nekuneko/ExSoKskeletal-Mitt/README.md

# ExSoKskeletal Mitt
Robotic Hand for ICTUS patients based on SoK (System on Keyring) boards.

Usign Autodesk EAGLE 9.5.2
