nekuneko/ExSoKskeletal-Mitt/Doc/sensor schematic.jpg

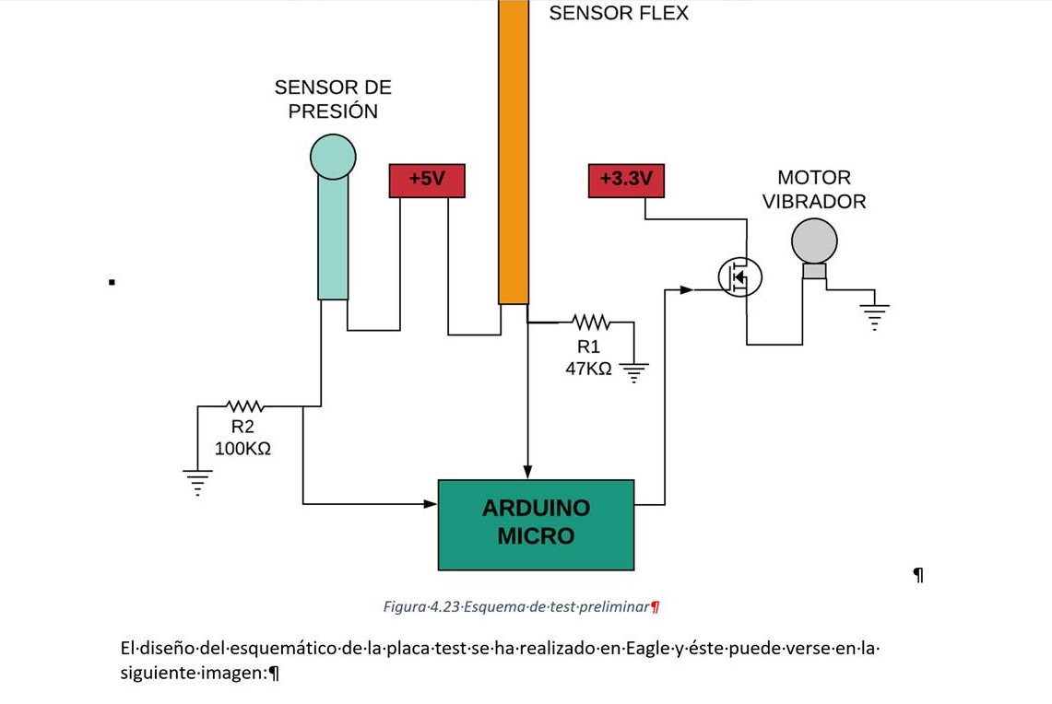
Doc/sensor schematic.jpg
