nekuneko/ExSoKskeletal-Mitt/PCB/finger/finger_changelog.txt

Finger 1.3 adds
	+ Resistor R5 is doubled to GND and 3.3V to allow potentiometer select I2C address easily.
