nekuneko/ExSoKskeletal-Mitt/PCB/hand/hand_rev_1.1_a.brd

## EAGLE design PCB/hand/hand_rev_1.1_a.brd (2019-07-13)

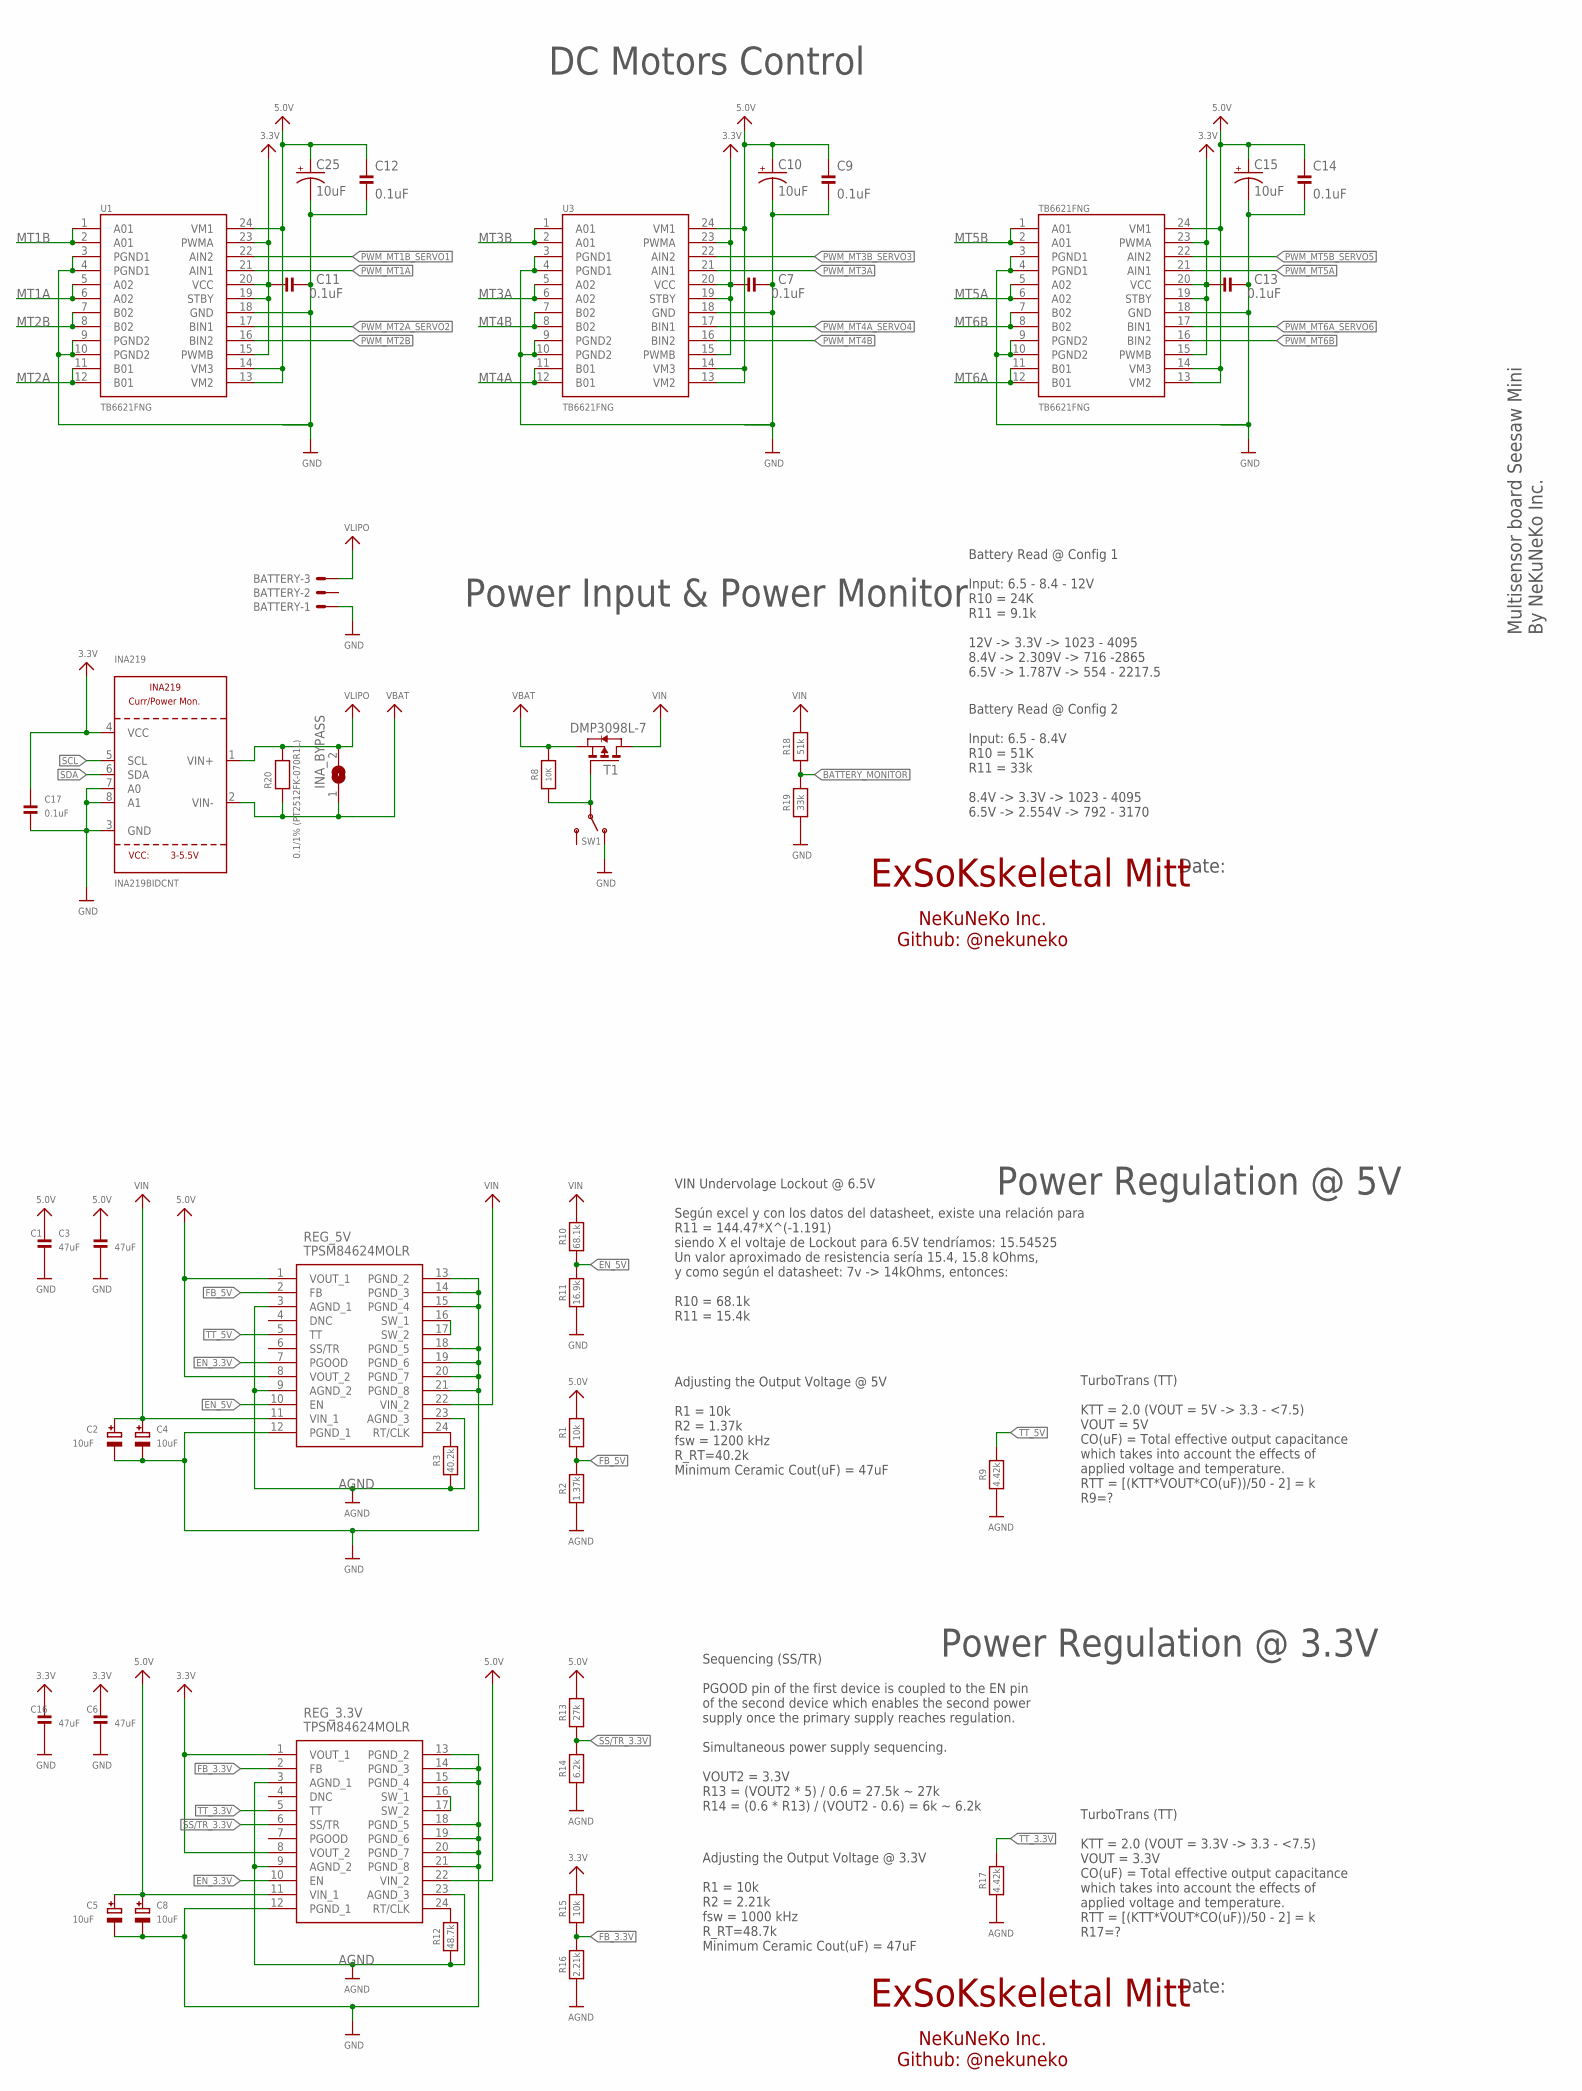
[picture p2: schematic hand_rev_1.1_a.sch, part in row 1, column 1]

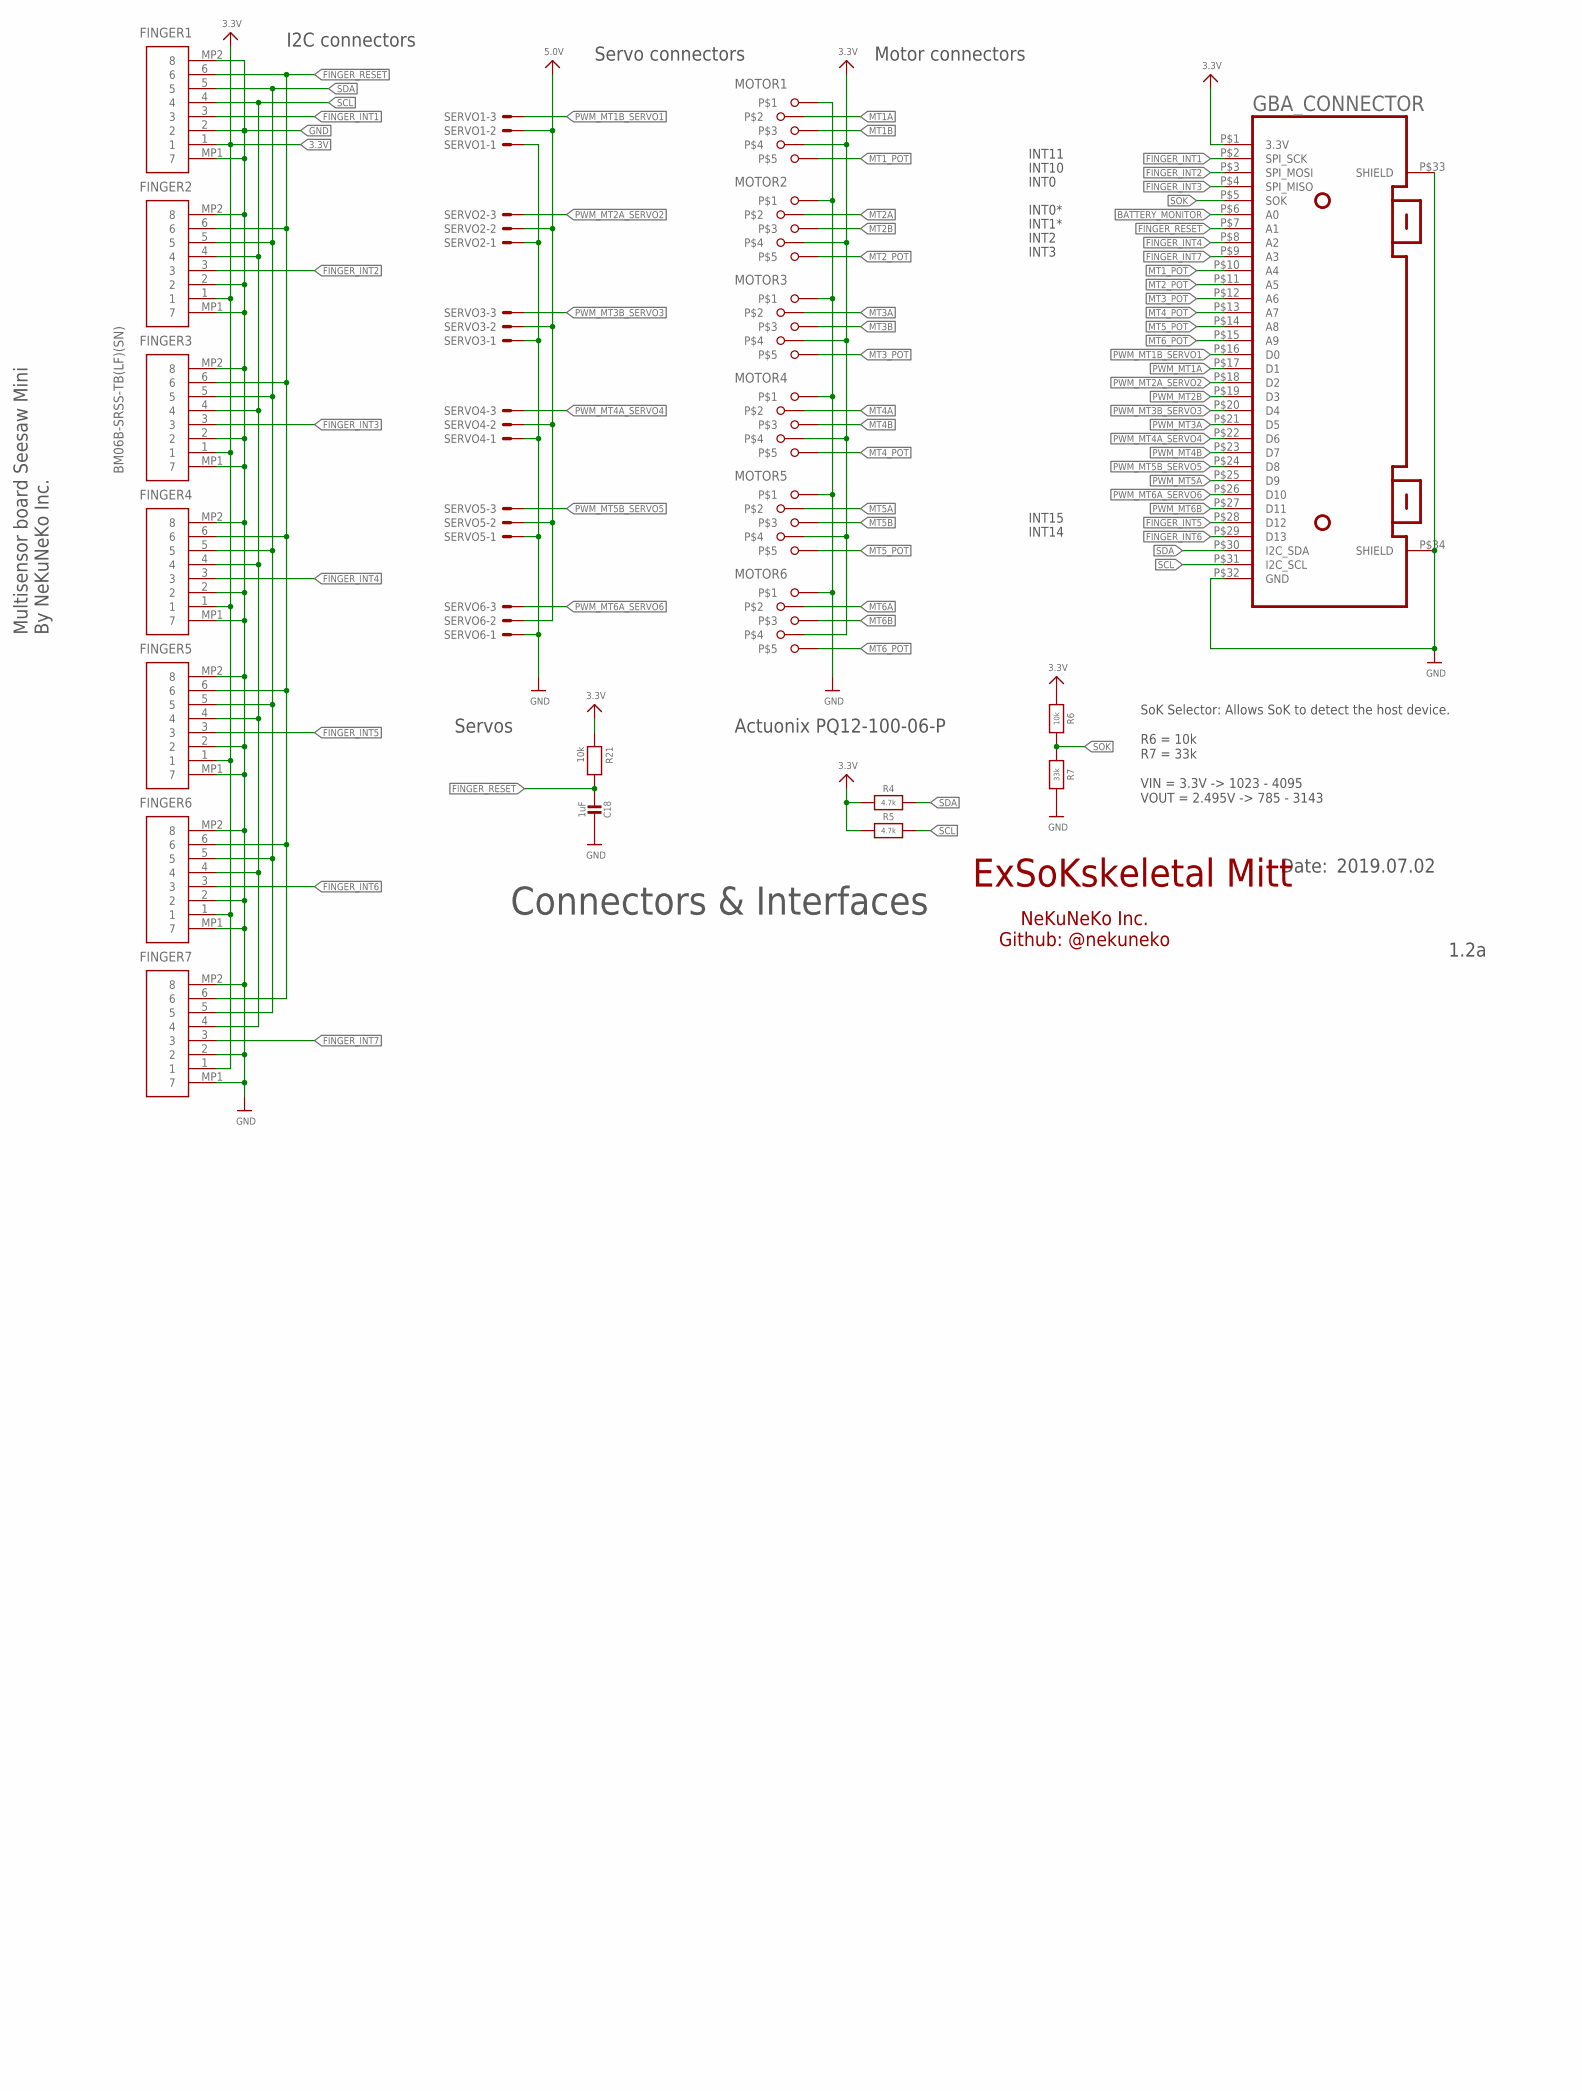
[picture p3: schematic hand_rev_1.1_a.sch, part in row 1, column 2]

Parts:
BATTERY: JST-XH-03-PIN-LONG-PAD; JST-XH-03-PACKAGE-LONG-PAD
C1, C3, C6, C16: 47uF; _0603
C2, C4, C5, C8: 10uF; EIA3216-18/A-R
C7, C9, C11, C12, C13, C14, C17: 0.1uF; _0603
C10, C15, C25: 10uF; 0603-POLAR; MPN F981A106MMA
C18: 1uF; MICROBUILDER__0603
FINGER1, FINGER2, FINGER3, FINGER4, FINGER5, FINGER6, FINGER7: BM06B-SRSS-TB(LF)(SN); BM06BSRSSTBLFSN
GBA_CONNECTOR: GBA_CARTRIDGEGBA_CARTRIDGE2; GBA_CARTRIDGE2
INA219: INA219BIDCNT; SOT23-8
INA_BYPASS: SOLDERJUMPERREFLOW_NOPASTE; SOLDERJUMPER_REFLOW_NOPASTE
MOTOR1, MOTOR2, MOTOR3, MOTOR4, MOTOR5, MOTOR6: Actuonix PQ12-100-06-P; 5PIN
R1, R6, R15, R21: 10k; _0603
R2: 1.37k; _0603
R3: 40.2k; _0603
R4, R5: 4.7k; _0603
R7, R19: 33k; _0603
R8: 10K; _0805
R9, R17: 4.42k; _0603
R10: 68.1k; _0603
R11: 16.9k; _0603
R12: 48.7k; _0603
R13: 27k; _0603
R14: 6.2k; _0603
R16: 2.21k; _0603
R18: 51k; _0603
R20: 0.1/1% (PT2512FK-070R1L); 2512
REG_3.3V, REG_5V: TPSM84624MOLR
SERVO1, SERVO2, SERVO3, SERVO4, SERVO5, SERVO6: JST-XH-03-PIN-LONG-PAD; JST-XH-03-PACKAGE-LONG-PAD
SW1: SWITCH_SPDT; SPDT_SMT_SSSS811101
T1: DMP3098L-7; SOT-23
TB6621FNG: TB6621FNG; SSOP24
U1, U3: TB6621FNG; SSOP24

Connections:
3.3V: C6.2, C7.1, C11.1, C13.1, C16.2, C17.2, FINGER1.1, FINGER2.1, FINGER3.1, FINGER4.1, FINGER5.1, FINGER6.1, FINGER7.1, GBA_CONNECTOR.P$1 (3.3V), INA219.4 (VCC), MOTOR1.4, MOTOR2.4, MOTOR3.4, MOTOR4.4, MOTOR5.4, MOTOR6.4, R4.1, R5.1, R6.1, R15.2, R21.1, REG_3.3V.1 (VOUT_1), REG_3.3V.8 (VOUT_2), TB6621FNG.15 (PWMB), TB6621FNG.19 (STBY), TB6621FNG.20 (VCC), TB6621FNG.23 (PWMA), U1.15 (PWMB), U1.19 (STBY), U1.20 (VCC), U1.23 (PWMA), U3.15 (PWMB), U3.19 (STBY), U3.20 (VCC), U3.23 (PWMA)
5.0V: C1.2, C3.2, C5.+, C8.+, C9.2, C10.+, C12.2, C14.2, C15.+, C25.+, R1.2, R13.2, REG_3.3V.11 (VIN_1), REG_3.3V.22 (VIN_2), REG_5V.1 (VOUT_1), REG_5V.8 (VOUT_2), SERVO1.2, SERVO2.2, SERVO3.2, SERVO4.2, SERVO5.2, SERVO6.2, TB6621FNG.13 (VM2), TB6621FNG.14 (VM3), TB6621FNG.24 (VM1), U1.13 (VM2), U1.14 (VM3), U1.24 (VM1), U3.13 (VM2), U3.14 (VM3), U3.24 (VM1)
AGND: R2.1, R3.1, R9.1, R12.1, R14.1, R16.1, R17.1, REG_3.3V.3 (AGND_1), REG_3.3V.9 (AGND_2), REG_3.3V.23 (AGND_3), REG_5V.3 (AGND_1), REG_5V.9 (AGND_2), REG_5V.23 (AGND_3)
BATTERY_MONITOR: GBA_CONNECTOR.P$6 (A0), R18.1, R19.2
EN_3.3V: REG_3.3V.10 (EN), REG_5V.7 (PGOOD)
EN_5V: R10.1, R11.2, REG_5V.10 (EN)
FB_3.3V: R15.1, R16.2, REG_3.3V.2 (FB)
FB_5V: R1.1, R2.2, REG_5V.2 (FB)
FINGER_!RESET: C18.2, FINGER1.6, FINGER2.6, FINGER3.6, FINGER4.6, FINGER5.6, FINGER6.6, FINGER7.6, GBA_CONNECTOR.P$7 (A1), R21.2
FINGER_INT1: FINGER1.3, GBA_CONNECTOR.P$2 (SPI_SCK)
FINGER_INT2: FINGER2.3, GBA_CONNECTOR.P$3 (SPI_MOSI)
FINGER_INT3: FINGER3.3, GBA_CONNECTOR.P$4 (SPI_MISO)
FINGER_INT4: FINGER4.3, GBA_CONNECTOR.P$8 (A2)
FINGER_INT5: FINGER5.3, GBA_CONNECTOR.P$28 (D12)
FINGER_INT6: FINGER6.3, GBA_CONNECTOR.P$29 (D13)
FINGER_INT7: FINGER7.3, GBA_CONNECTOR.P$9 (A3)
GND: BATTERY.1, C1.1, C2.-, C3.1, C4.-, C5.-, C6.1, C7.2, C8.-, C9.1, C10.-, C11.2, C12.1, C13.2, C14.1, C15.-, C16.1, C17.1, C18.1, C25.-, FINGER1.2, FINGER1.MP1 (7), FINGER1.MP2 (8), FINGER2.2, FINGER2.MP1 (7), FINGER2.MP2 (8), FINGER3.2, FINGER3.MP1 (7), FINGER3.MP2 (8), FINGER4.2, FINGER4.MP1 (7), FINGER4.MP2 (8), FINGER5.2, FINGER5.MP1 (7), FINGER5.MP2 (8), FINGER6.2, FINGER6.MP1 (7), FINGER6.MP2 (8), FINGER7.2, FINGER7.MP1 (7), FINGER7.MP2 (8), GBA_CONNECTOR.P$32 (GND), GBA_CONNECTOR.P$33 (SHIELD), GBA_CONNECTOR.P$34 (SHIELD), INA219.3 (GND), INA219.7 (A0), INA219.8 (A1), MOTOR1.1, MOTOR2.1, MOTOR3.1, MOTOR4.1, MOTOR5.1, MOTOR6.1, R7.2, R11.1, R19.1, REG_3.3V.12 (PGND_1), REG_3.3V.13 (PGND_2), REG_3.3V.14 (PGND_3), REG_3.3V.15 (PGND_4), REG_3.3V.18 (PGND_5), REG_3.3V.19 (PGND_6), REG_3.3V.20 (PGND_7), REG_3.3V.21 (PGND_8), REG_5V.12 (PGND_1), REG_5V.13 (PGND_2), REG_5V.14 (PGND_3), REG_5V.15 (PGND_4), REG_5V.18 (PGND_5), REG_5V.19 (PGND_6), REG_5V.20 (PGND_7), REG_5V.21 (PGND_8), SERVO1.1, SERVO2.1, SERVO3.1, SERVO4.1, SERVO5.1, SERVO6.1, SW1.A (O), TB6621FNG.3 (PGND1), TB6621FNG.4 (PGND1), TB6621FNG.9 (PGND2), TB6621FNG.10 (PGND2), TB6621FNG.18 (GND), U1.3 (PGND1), U1.4 (PGND1), U1.9 (PGND2), U1.10 (PGND2), U1.18 (GND), U3.3 (PGND1), U3.4 (PGND1), U3.9 (PGND2), U3.10 (PGND2), U3.18 (GND)
MT1A: MOTOR1.2, U1.5 (A02), U1.6 (A02)
MT1B: MOTOR1.3, U1.1 (A01), U1.2 (A01)
MT1_POT: GBA_CONNECTOR.P$10 (A4), MOTOR1.5
MT2A: MOTOR2.2, U1.11 (B01), U1.12 (B01)
MT2B: MOTOR2.3, U1.7 (B02), U1.8 (B02)
MT2_POT: GBA_CONNECTOR.P$11 (A5), MOTOR2.5
MT3A: MOTOR3.2, U3.5 (A02), U3.6 (A02)
MT3B: MOTOR3.3, U3.1 (A01), U3.2 (A01)
MT3_POT: GBA_CONNECTOR.P$12 (A6), MOTOR3.5
MT4A: MOTOR4.2, U3.11 (B01), U3.12 (B01)
MT4B: MOTOR4.3, U3.7 (B02), U3.8 (B02)
MT4_POT: GBA_CONNECTOR.P$13 (A7), MOTOR4.5
MT5A: MOTOR5.2, TB6621FNG.5 (A02), TB6621FNG.6 (A02)
MT5B: MOTOR5.3, TB6621FNG.1 (A01), TB6621FNG.2 (A01)
MT5_POT: GBA_CONNECTOR.P$14 (A8), MOTOR5.5
MT6A: MOTOR6.2, TB6621FNG.11 (B01), TB6621FNG.12 (B01)
MT6B: MOTOR6.3, TB6621FNG.7 (B02), TB6621FNG.8 (B02)
MT6_POT: GBA_CONNECTOR.P$15 (A9), MOTOR6.5
unnamed: R8.1, SW1.B, T1.3 (G)
unnamed: REG_5V.16 (SW_1), REG_5V.17 (SW_2)
unnamed: R12.2, REG_3.3V.24 (RT/CLK)
unnamed: REG_3.3V.16 (SW_1), REG_3.3V.17 (SW_2)
unnamed: R3.2, REG_5V.24 (RT/CLK)
PWM_MT1A: GBA_CONNECTOR.P$17 (D1), U1.21 (AIN1)
PWM_MT1B_SERVO1: GBA_CONNECTOR.P$16 (D0), SERVO1.3, U1.22 (AIN2)
PWM_MT2A_SERVO2: GBA_CONNECTOR.P$18 (D2), SERVO2.3, U1.17 (BIN1)
PWM_MT2B: GBA_CONNECTOR.P$19 (D3), U1.16 (BIN2)
PWM_MT3A: GBA_CONNECTOR.P$21 (D5), U3.21 (AIN1)
PWM_MT3B_SERVO3: GBA_CONNECTOR.P$20 (D4), SERVO3.3, U3.22 (AIN2)
PWM_MT4A_SERVO4: GBA_CONNECTOR.P$22 (D6), SERVO4.3, U3.17 (BIN1)
PWM_MT4B: GBA_CONNECTOR.P$23 (D7), U3.16 (BIN2)
PWM_MT5A: GBA_CONNECTOR.P$25 (D9), TB6621FNG.21 (AIN1)
PWM_MT5B_SERVO5: GBA_CONNECTOR.P$24 (D8), SERVO5.3, TB6621FNG.22 (AIN2)
PWM_MT6A_SERVO6: GBA_CONNECTOR.P$26 (D10), SERVO6.3, TB6621FNG.17 (BIN1)
PWM_MT6B: GBA_CONNECTOR.P$27 (D11), TB6621FNG.16 (BIN2)
SCL: FINGER1.4, FINGER2.4, FINGER3.4, FINGER4.4, FINGER5.4, FINGER6.4, FINGER7.4, GBA_CONNECTOR.P$31 (I2C_SCL), INA219.5 (SCL), R5.2
SDA: FINGER1.5, FINGER2.5, FINGER3.5, FINGER4.5, FINGER5.5, FINGER6.5, FINGER7.5, GBA_CONNECTOR.P$30 (I2C_SDA), INA219.6 (SDA), R4.2
SOK: GBA_CONNECTOR.P$5 (SOK), R6.2, R7.1
SS/TR_3.3V: R13.1, R14.2, REG_3.3V.6 (SS/TR)
TT_3.3V: R17.2, REG_3.3V.5 (TT)
TT_5V: R9.2, REG_5V.5 (TT)
VBAT: INA219.2 (VIN-), INA_BYPASS.1, R8.2, R20.1, T1.2 (S)
VIN: C2.+, C4.+, R10.2, R18.2, REG_5V.11 (VIN_1), REG_5V.22 (VIN_2), T1.1 (D)
VLIPO: BATTERY.3, INA219.1 (VIN+), INA_BYPASS.2, R20.2

Notes on the sheet:
ExSoKskeletal Mitt
VIN Undervolage Lockout @ 6.5V Según excel y con los datos del datasheet, existe una relación para R11 = 144.47*X^(-1.191) siendo X el voltaje de Lockout para 6.5V tendríamos: 15.54525 Un valor aproximado de resistencia sería 15.4, 15.8 kOhms, y como según el datasheet: 7v -> 14kOhms, entonces: R10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
Adjusting the Output Voltage @ 5V R1 = 10k R2 = 1.37k fsw = 1200 kHz R_RT=40.2k Minimum Ceramic Cout(uF) = 47uF
Sequencing (SS/TR) PGOOD pin of the first device is coupled to the EN pin of the second device which enables the second power supply once the primary supply reaches regulation. Simultaneous power supply sequencing. VOUT2 = 3.3V R13 = (VOUT2 * 5) / 0.6 = 27.5k ~ 27k R14 = (0.6 * R13) / (VOUT2 - 0.6)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
Adjusting the Output Voltage @ 3.3V R1 = 10k R2 = 2.21k fsw = 1000 kHz R_RT=48.7k Minimum Ceramic Cout(uF) = 47uF
TurboTrans (TT) KTT = 2.0 (VOUT = 5V -> 3.3 - <7.5) VOUT = 5V CO(uF) = Total effective output capacitance which takes into account the effects of applied voltage and temperature. RTT = [(KTT*VOUT*CO(uF))/50 - 2] = k R9=?
TurboTrans (TT) KTT = 2.0 (VOUT = 3.3V -> 3.3 - <7.5) VOUT = 3.3V CO(uF) = Total effective output capacitance which takes into account the effects of applied voltage and temperature. RTT = [(KTT*VOUT*CO(uF))/50 - 2] = k R17=?
INT11
INT10
INT0
INT0*
INT1*
INT2
INT3
INT14
INT15
Battery Read @ Config 2 Input: 6.5 - 8.4V R10 = 51K R11 = 33k 8.4V -> 3.3V -> 1023 - 4095 6.5V -> 2.554V -> 792 - 3170
Power Input & Power Monitor
Power Regulation @ 5V
Power Regulation @ 3.3V
DC Motors Control
Connectors & Interfaces
NeKuNeKo Inc. Github: @nekuneko
Date:
SoK Selector: Allows SoK to detect the host device. R6 = 10k R7 = 33k VIN = 3.3V -> 1023 - 4095 VOUT = 2.495V -> 785 - 3143
I2C connectors
Servo connectors
Motor connectors
Actuonix PQ12-100-06-P
Multisensor board Seesaw Mini By NeKuNeKo Inc.
Servos
Battery Read @ Config 1 Input: 6.5 - 8.4 - 12V R10 = 24K R11 = 9.1k 12V -> 3.3V -> 1023 - 4095 8.4V -> 2.309V -> 716 -2865 6.5V -> 1.787V -> 554 - 2217.5

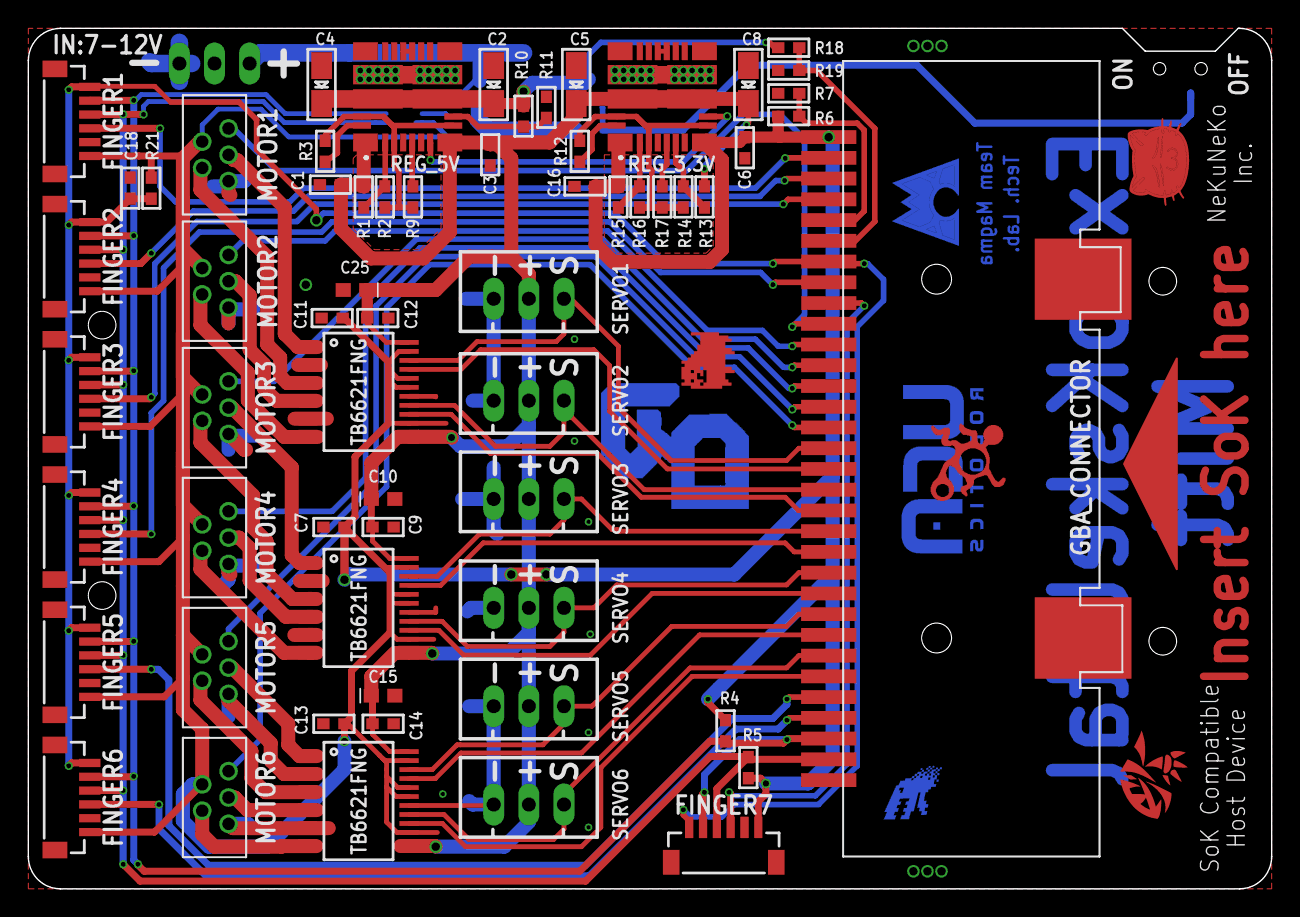
[picture p4: board hand_rev_1.1_a.brd from above]

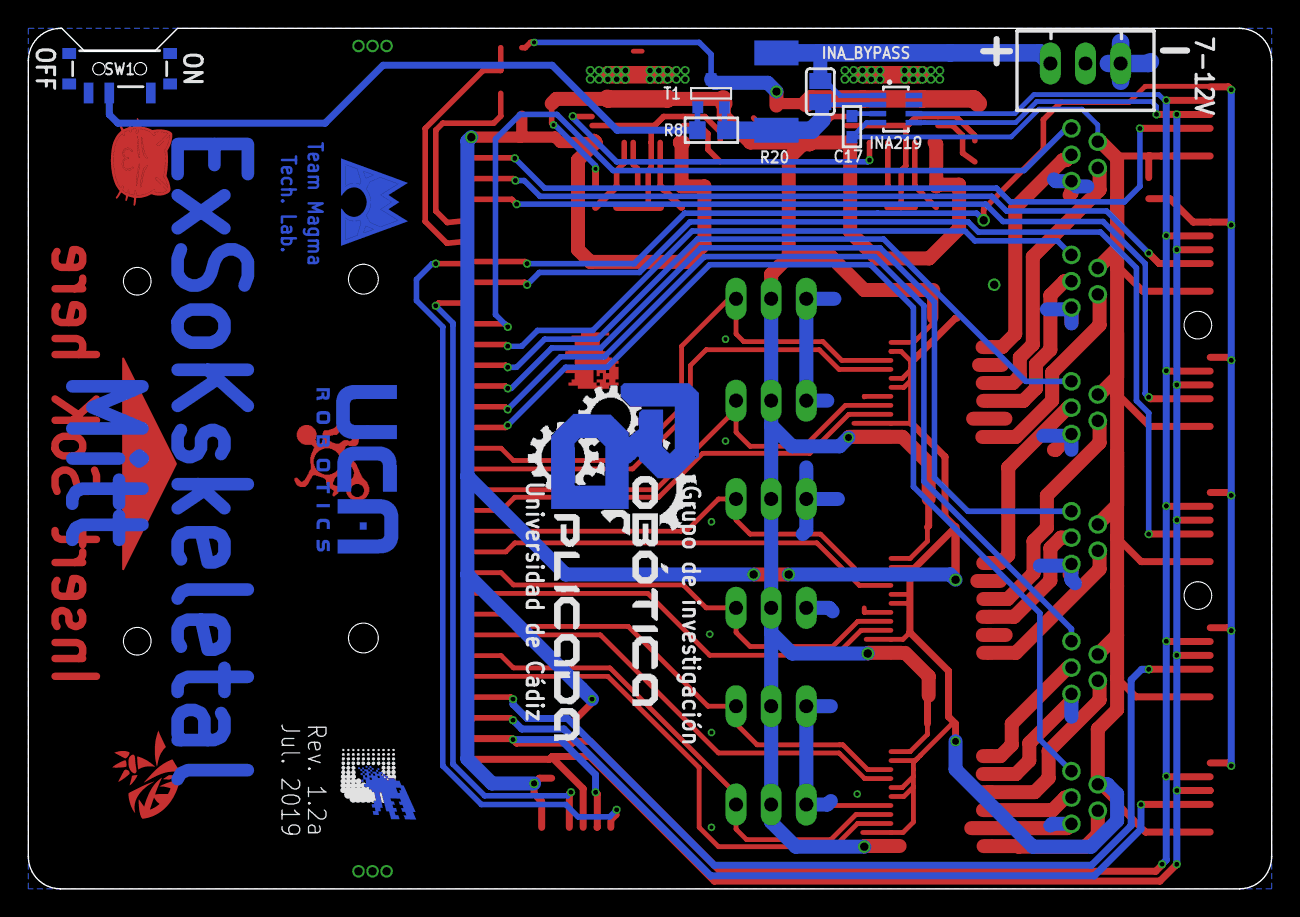
[picture p5: board hand_rev_1.1_a.brd from below]

Board: 2 copper layers, 89.9 x 62.2 mm, 79 parts (12 on the bottom side), 61 nets.

Other parts of the board:
U$6: NEKO_6_5_BORDE_TSTOP
U$7: SOK_FINISH
U$8: DOG_FINISH
U$9: MAGMA
U$14: UCAROBOTICS
U$48: GIRA_2_DRAWN_14
U$50: TRIANGLE
U$51: DIGIMON
U$52: BUGS_6
