nekuneko/ExSoKskeletal-Mitt/PCB/# old/finger_rev_1.2.brd

## EAGLE design PCB/# old/finger_rev_1.2.brd (2019-07-13, an earlier design)

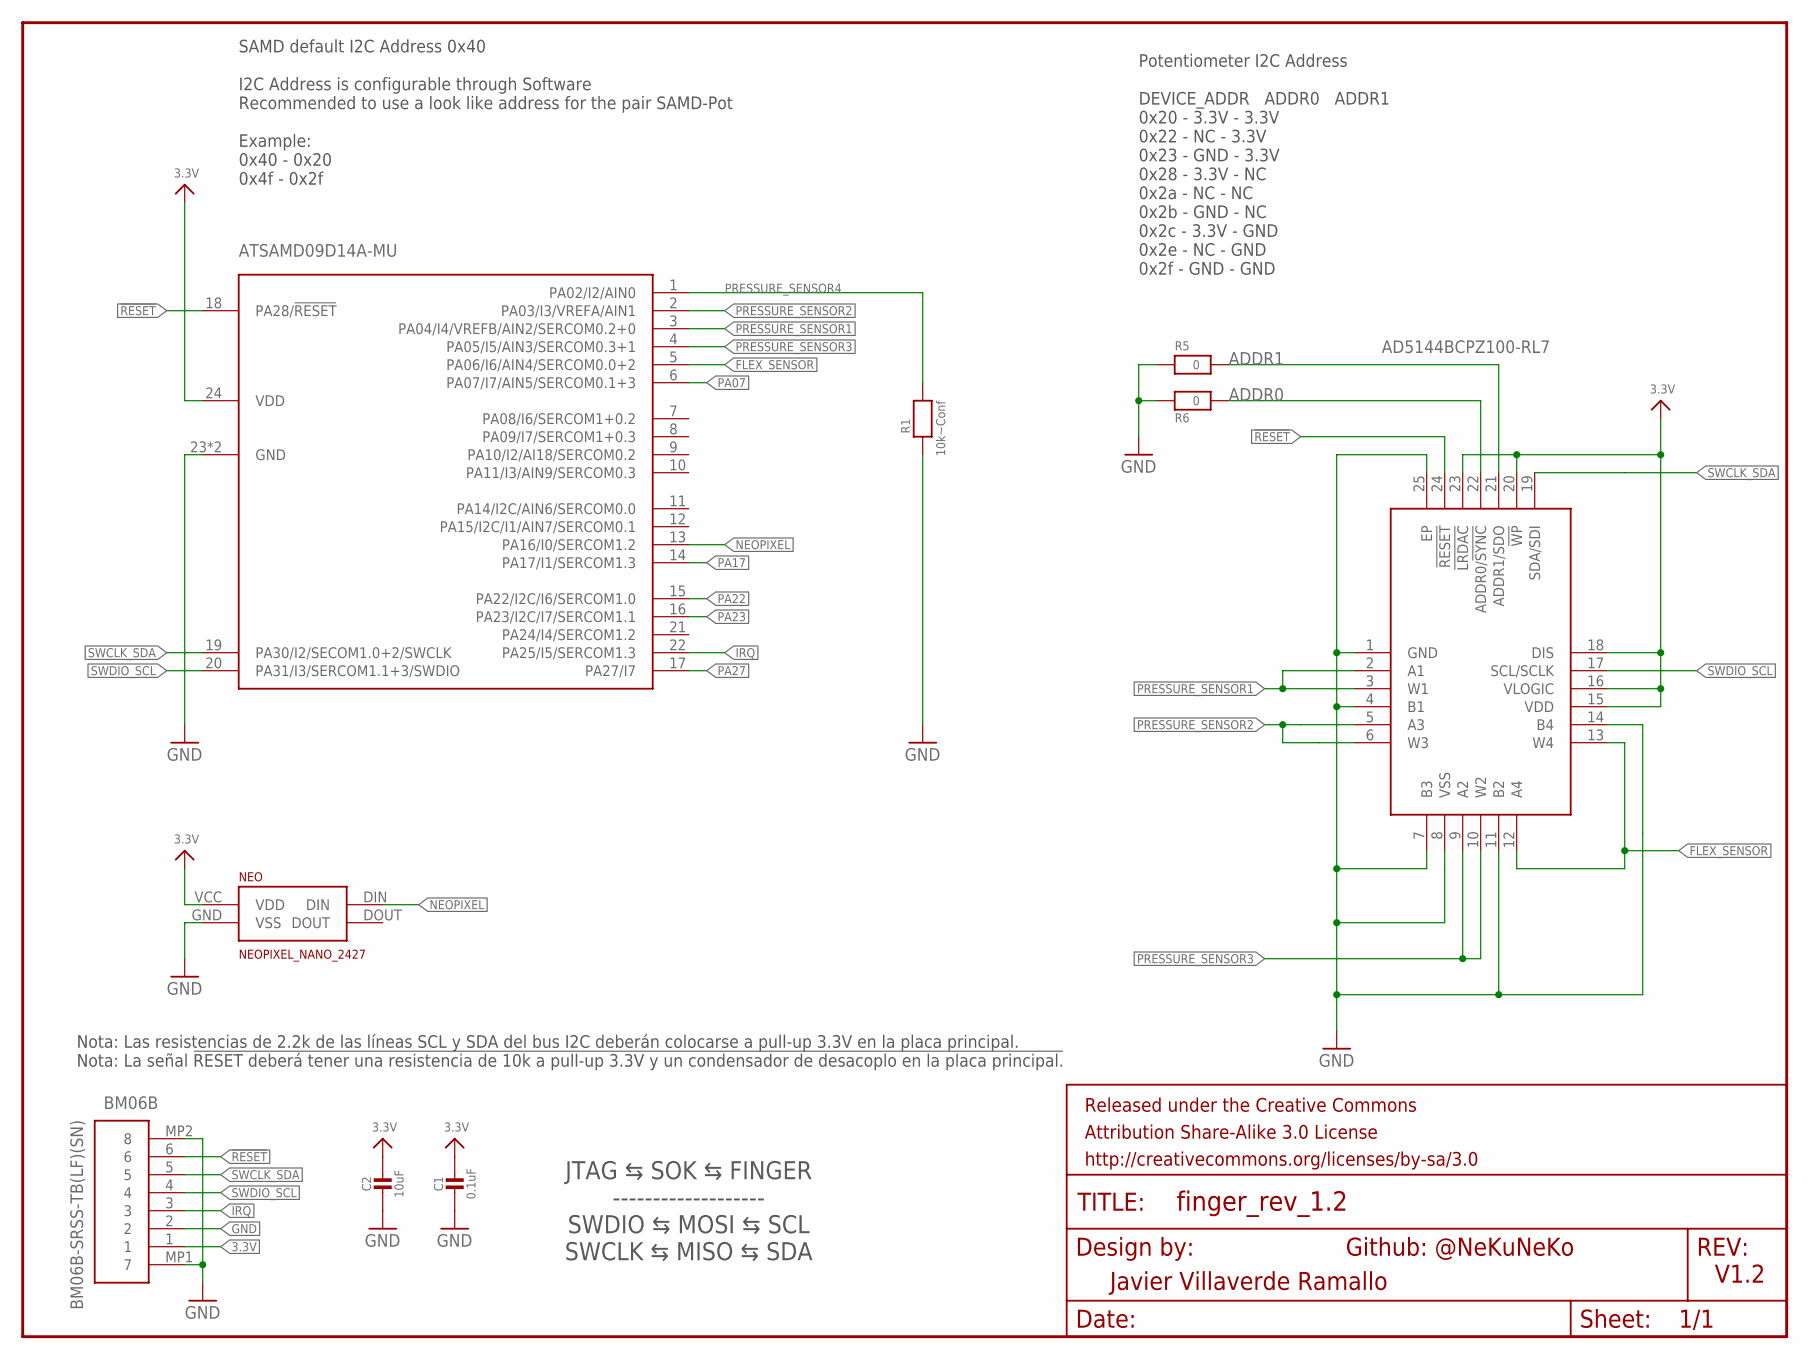
[picture p6: schematic finger_rev_1.2.sch]

Parts:
AD5144BCPZ100: AD5144BCPZ100-RL7; QFN50P400X400X80-25N
BM06B: BM06B-SRSS-TB(LF)(SN); BM06BSRSSTBLFSN
C1: 0.1uF; 0402
C2: 10uF; 0402
FRAME1, FRAME2: FRAME-LETTER; CREATIVE_COMMONS
NEO: NEOPIXEL_NANO_2427; SK6805-2427
R1: 10k~Conf; _0402
R5, R6: 0; _0402
SAMD09: ATSAMD09D14A-MU; QFN24_4MM

Connections:
3.3V: AD5144BCPZ100.15 (VDD), AD5144BCPZ100.16 (VLOGIC), AD5144BCPZ100.18 (DIS), AD5144BCPZ100.20 (!WP), AD5144BCPZ100.23 (!LRDAC), BM06B.1, C1.1, C2.1, NEO.VCC (VDD), SAMD09.24 (VDD)
!RESET: AD5144BCPZ100.24 (!RESET), BM06B.6, SAMD09.18 (PA28/!RESET)
ADDR0: AD5144BCPZ100.22 (ADDR0/!SYNC), R6.2
ADDR1: AD5144BCPZ100.21 (ADDR1/SDO), R5.2
FLEX_SENSOR: AD5144BCPZ100.12 (A4), AD5144BCPZ100.13 (W4), SAMD09.5 (PA06/I6/AIN4/SERCOM0.0+2)
GND: AD5144BCPZ100.1 (GND), AD5144BCPZ100.4 (B1), AD5144BCPZ100.7 (B3), AD5144BCPZ100.8 (VSS), AD5144BCPZ100.11 (B2), AD5144BCPZ100.14 (B4), AD5144BCPZ100.25 (EP), BM06B.2, BM06B.MP1 (7), BM06B.MP2 (8), C1.2, C2.2, NEO.GND (VSS), R1.2, R5.1, R6.1, SAMD09.23 (GND), SAMD09.THERM (GND)
IRQ: BM06B.3, SAMD09.22 (PA25/I5/SERCOM1.3)
NEOPIXEL: NEO.DIN, SAMD09.13 (PA16/I0/SERCOM1.2)
PA07: SAMD09.6 (PA07/I7/AIN5/SERCOM0.1+3)
PA17: SAMD09.14 (PA17/I1/SERCOM1.3)
PA22: SAMD09.15 (PA22/I2C/I6/SERCOM1.0)
PA23: SAMD09.16 (PA23/I2C/I7/SERCOM1.1)
PA27: SAMD09.17 (PA27/I7)
PRESSURE_SENSOR1: AD5144BCPZ100.2 (A1), AD5144BCPZ100.3 (W1), SAMD09.3 (PA04/I4/VREFB/AIN2/SERCOM0.2+0)
PRESSURE_SENSOR2: AD5144BCPZ100.5 (A3), AD5144BCPZ100.6 (W3), SAMD09.2 (PA03/I3/VREFA/AIN1)
PRESSURE_SENSOR3: AD5144BCPZ100.9 (A2), AD5144BCPZ100.10 (W2), SAMD09.4 (PA05/I5/AIN3/SERCOM0.3+1)
PRESSURE_SENSOR4: R1.1, SAMD09.1 (PA02/I2/AIN0)
SWCLK_SDA: AD5144BCPZ100.19 (SDA/SDI), BM06B.5, SAMD09.19 (PA30/I2/SECOM1.0+2/SWCLK)
SWDIO_SCL: AD5144BCPZ100.17 (SCL/SCLK), BM06B.4, SAMD09.20 (PA31/I3/SERCOM1.1+3/SWDIO)

Notes on the sheet:
Nota: Las resistencias de 2.2k de las líneas SCL y SDA del bus I2C deberán colocarse a pull-up 3.3V en la placa principal. Nota: La señal !RESET deberá tener una resistencia de 10k a pull-up 3.3V y un condensador de desacoplo en la placa principal.
Github: @NeKuNeKo
V1.2
Javier Villaverde Ramallo
Potentiometer I2C Address DEVICE_ADDR ADDR0 ADDR1 0x20 - 3.3V - 3.3V 0x22 - NC - 3.3V 0x23 - GND - 3.3V 0x28 - 3.3V - NC 0x2a - NC - NC 0x2b - GND - NC 0x2c - 3.3V - GND 0x2e - NC - GND 0x2f - GND - GND
SAMD default I2C Address 0x40 I2C Address is configurable through Software Recommended to use a look like address for the pair SAMD-Pot Example: 0x40 - 0x20 0x4f - 0x2f
JTAG ⇆ SOK ⇆ FINGER ------------------- SWDIO ⇆ MOSI ⇆ SCL SWCLK ⇆ MISO ⇆ SDA

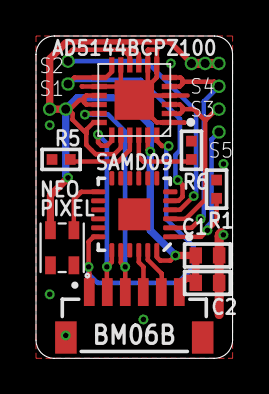
[picture p7: board finger_rev_1.2.brd from above]

Board: 2 copper layers, 10.9 x 17.9 mm, 12 parts (1 on the bottom side), 14 nets.

Other parts of the board:
U$1: NEKO_DRAWN
