nekuneko/ExSoKskeletal-Mitt/PCB/dedo_prog/dedo_prog_r1.2.brd

## EAGLE design PCB/dedo_prog/dedo_prog_r1.2.brd (2019-08-30)

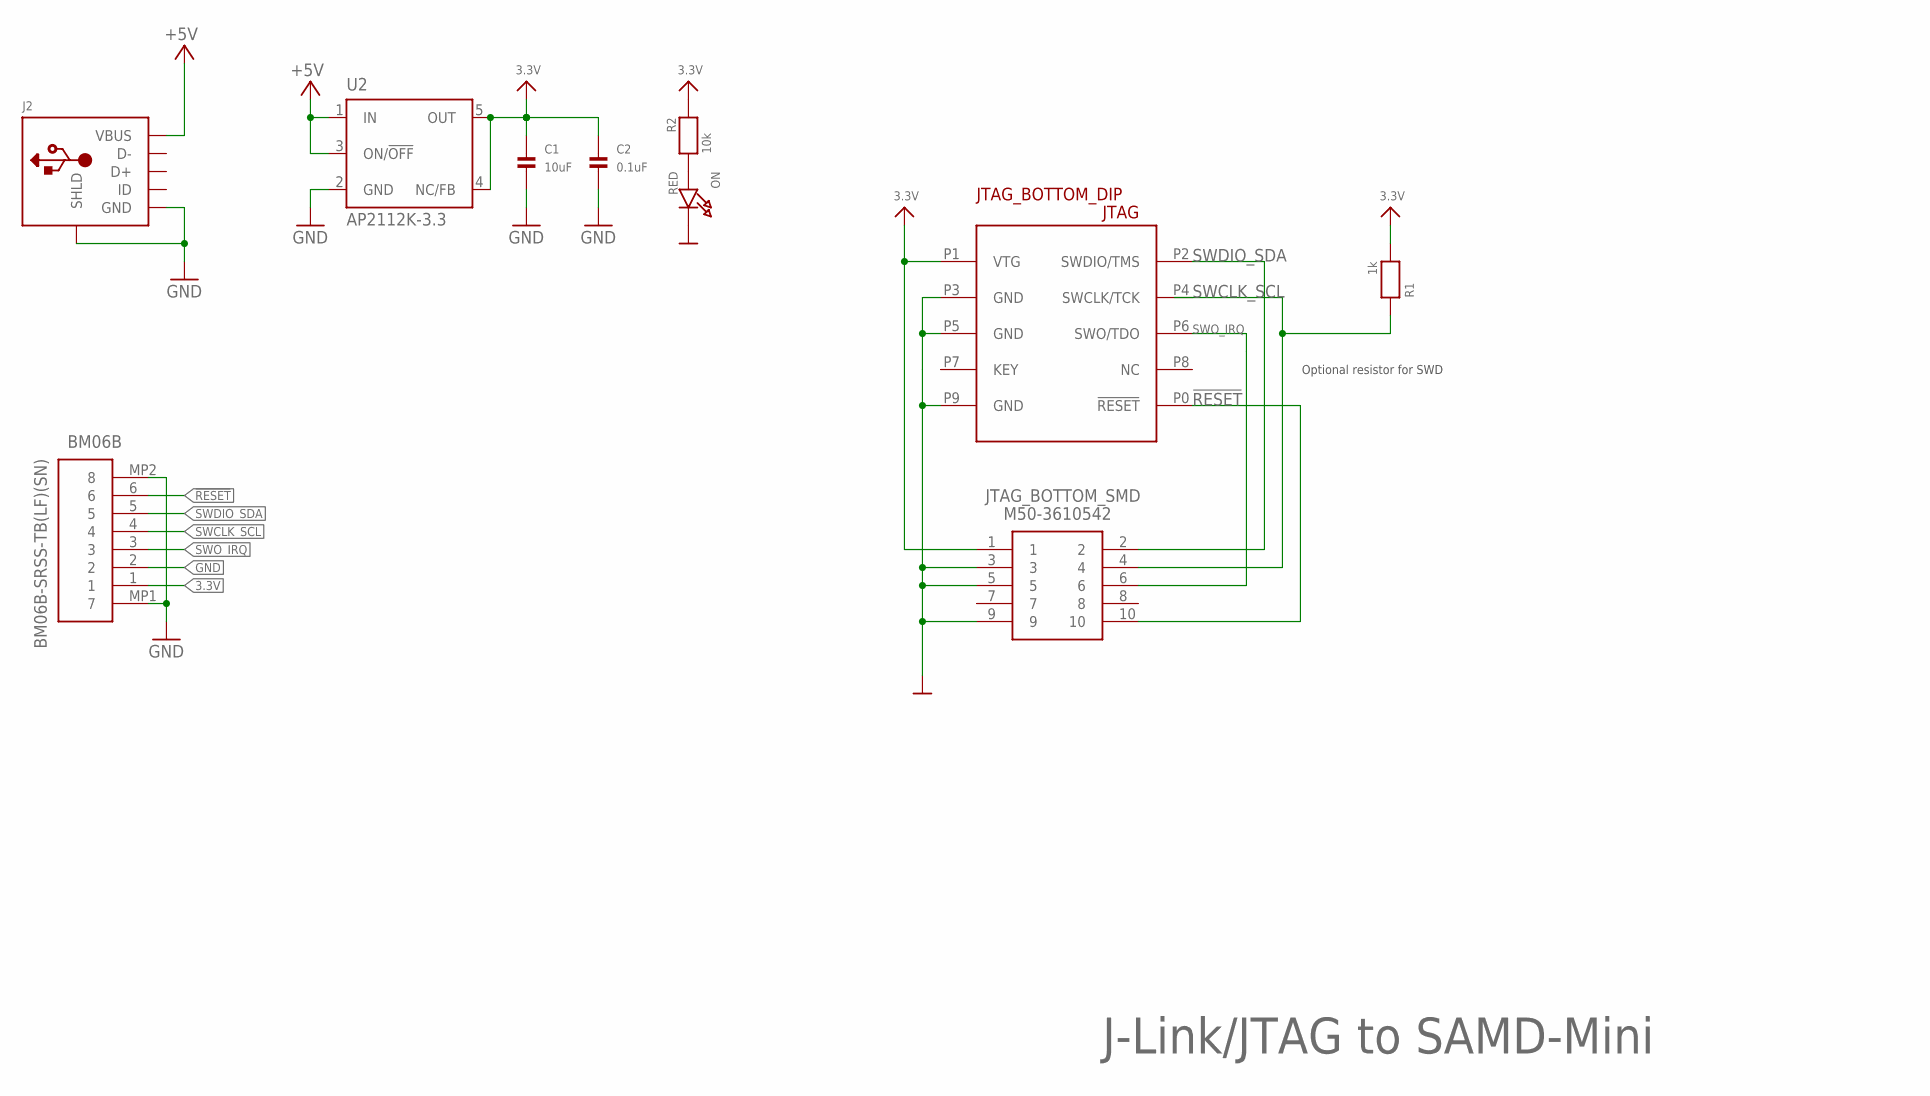
[picture p8: schematic dedo_prog_r1.2.sch]

Parts:
BM06B: BM06B-SRSS-TB(LF)(SN); BM06BSRSSTBLFSN
C1: 10uF; _0402
C2: 0.1uF; _0402
J2: FLAT_MICROUSB_ALIEXPRESS_TYPE_4; USB_TYPE_4_105164-0001
JTAG_BOTTOM_DIP: JTAGICE3-CONNECTOR50MIL-THT; JTAGICE3-50MIL
JTAG_BOTTOM_SMD: M50-3610542; M503610542
ON: RED; CHIPLED_0603
R1: 1k; _0402
R2: 10k; _0402
U2: AP2112K-3.3; SOT23-DBV

Connections:
3.3V: BM06B.1, C1.1, C2.1, JTAG_BOTTOM_DIP.P1 (VTG), JTAG_BOTTOM_SMD.1, R1.2, R2.2, U2.4 (NC/FB), U2.5 (OUT)
!RESET: BM06B.6, JTAG_BOTTOM_DIP.P0 (!RESET), JTAG_BOTTOM_SMD.10
+5V: J2.P$5 (VBUS), U2.1 (IN), U2.3 (ON/!OFF)
GND: BM06B.2, BM06B.MP1 (7), BM06B.MP2 (8), C1.2, C2.2, J2.P$1 (GND), J2.P$8 (SHLD), J2.P$9 (SHLD), JTAG_BOTTOM_DIP.P3 (GND), JTAG_BOTTOM_DIP.P5 (GND), JTAG_BOTTOM_DIP.P9 (GND), JTAG_BOTTOM_SMD.3, JTAG_BOTTOM_SMD.5, JTAG_BOTTOM_SMD.9, ON.C, U2.2 (GND)
unnamed: ON.A, R2.1
SWCLK_SCL: BM06B.4, JTAG_BOTTOM_DIP.P4 (SWCLK/TCK), JTAG_BOTTOM_SMD.4, R1.1
SWDIO_SDA: BM06B.5, JTAG_BOTTOM_DIP.P2 (SWDIO/TMS), JTAG_BOTTOM_SMD.2
SWO_IRQ: BM06B.3, JTAG_BOTTOM_DIP.P6 (SWO/TDO), JTAG_BOTTOM_SMD.6

Notes on the sheet:
Optional resistor for SWD
J-Link/JTAG to SAMD-Mini

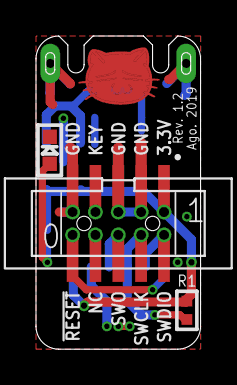
[picture p9: board dedo_prog_r1.2.brd from above]

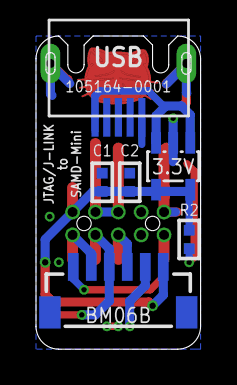
[picture p10: board dedo_prog_r1.2.brd from below]

Board: 2 copper layers, 9.1 x 17.4 mm, 12 parts (7 on the bottom side), 8 nets.

Other parts of the board:
U$4: NEKO_5_3_TSTOP_TOP
U$5: USB_TYPE_4_DIM
