nekuneko/ExSoKskeletal-Mitt/PCB/br-BM05B.brd

## EAGLE design PCB/br-BM05B.brd (2019-08-30)

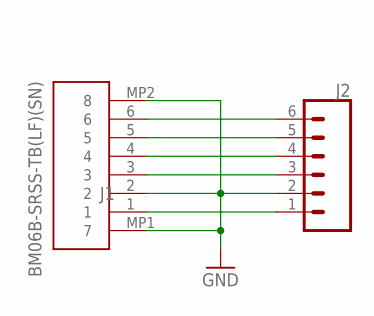
[picture p11: schematic br-BM05B.sch]

Parts:
J1: BM06B-SRSS-TB(LF)(SN); BM06BSRSSTBLFSN
J2: CONN_06NO_SILK_FEMALE_PTH; 1X06_NO_SILK

Connections:
GND: J1.2, J1.MP1 (7), J1.MP2 (8), J2.2
unnamed: J1.1, J2.1
unnamed: J1.3, J2.3
unnamed: J1.4, J2.4
unnamed: J1.5, J2.5
unnamed: J1.6, J2.6

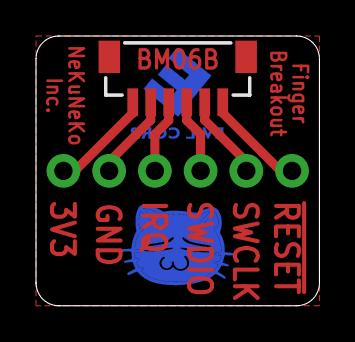
[picture p12: board br-BM05B.brd from above]

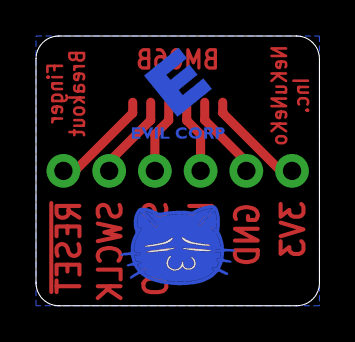
[picture p13: board br-BM05B.brd from below]

Board: 2 copper layers, 15.7 x 15.0 mm, 4 parts (2 on the bottom side), 6 nets.

Other parts of the board:
U$1: NEKO_6_5_BORDE_SILK
U$2: ECORP_TSTOP_6
