nekuneko/ExSoKskeletal-Mitt/(commit log)

2019-08-30 Cambio de nombres y ubicación
    [dedo_prog.brd, dedo_prog.sch, dedo_rev_1_2.sch, mano_rev_1_1_a.brd, mano_rev_1_1_a.sch, mano_rev_1_2_b.brd, mano_rev_1_2_b.sch]
2019-08-30 Breakout del conector BM05B
    [br-BM05B.brd, br-BM05B.sch]
2019-08-30 Mini Programador para Finger SoK
    [dedo_prog_r1.2.brd, dedo_prog_r1.2.sch]
2019-08-30 Mano robótica con regulador de tensión 3.3V 2A TPS
    [mano_rev_1_3_c.brd, mano_rev_1_3_c.sch]
2019-09-24 Updated pinout
    [PinoutManoBiónica.xlsx, pinoutExoSoKskeletalMitt.xlsx]
2019-10-11 Change name
    [hand_rev_1_1_a.brd, hand_rev_1_1_a.sch, hand_rev_1_2_b.brd, hand_rev_1_2_b.sch, hand_rev_1_3_c.brd, hand_rev_1_3_c.sch]
2019-11-14 Finger Rev 1.3: Resistor R5 is doubled to GND and 3.3V to allow potentiometer select I2C address easily.
    [finger_r1.3.brd, finger_r1.3.sch]
2019-11-14 Rev 1.3: Corrected FingerSoK pinout and added serigraph changes
    [finger_jlink_r1.3.brd, finger_jlink_r1.3.sch, finger_jlink_r1.3b.brd, finger_jlink_r1.3b.sch]
2019-11-14 Changes in serigraph and now Led ON es below the board, following KittySyringe 1.1 design.
    [finger_jlink_r1.4.brd, finger_jlink_r1.4.sch]
2019-11-20 renaming & realocate files
    [finger_jlink_r1.2.brd, finger_jlink_r1.2.sch, finger_jlink_r1.3.brd, finger_jlink_r1.3.sch, finger_jlink_r1.3b.brd, finger_jlink_r1.3b.sch, finger_jlink_r1.4.brd, finger_jlink_r1.4.sch]
